RyanPage-cu/SYSC4805_Project_Repo/(commit log)

2025-10-11 adding another line sensor code
2025-10-11 Refactor setup and loop functions to include all line follower sensor pins and update logic for reading sensor states
2025-10-12 Update motor and sensor pin definitions for improved functionality
2025-10-12 Add Due_Code.cpp with motor control, ultrasonic sensor, and line follower functionality
2025-10-31 Add distance sensor functionality with reporting
    Implement distance sensing using two Sharp GP2Y0A51SK0F sensors. Each sensor reports if an object is detected within ~8 cm based on voltage readings.
2025-11-14 Add Watchdog timer
2025-11-16 Refactor distance sensor and ultrasonic modules for improved readability and functionality
2025-11-16 Rename ultrasonic function for clarity and add readSharpDistances function for improved distance measurement
2025-11-19 Refactor ultrasonic distance reading functions for improved accuracy and add stepForward function for controlled movement
2025-11-19 Add test main function for standalone testing of sensors and motors
2025-11-19 Refactor loop function to improve readability and temporarily disable sensor detection logic
2025-11-20 Add Time of Flight sensor implementation and refactor pivot control for non-blocking operation
2025-11-20 Implement dual Time of Flight sensor initialization and reading; refactor sensor setup in main file
2025-11-20 Refactor distance sensor implementation: remove Sharp sensor code, update ultrasonic sensor functions for dual sensor support, and adjust main loop for new readings.
2025-11-20 Enhance Time of Flight sensor initialization with error handling and success messages; refactor distance reading logic in main loop for clarity and improved functionality.
    [roboplow.ino]
2025-11-20 Refactor sensor modules: remove ultrasonic and line follower implementations, add IR obstacle detection sensor functionality, and update sensor initialization in main file.
2025-11-21 Refactor sensor initialization: add functions for motor, ultrasonic, line detection, and IR sensor setup; remove line detection sensor implementation file.
2025-11-21 Add magnetometer direction support
2025-11-26 Prototype implementation of FSM
2025-11-26 sensors.hpp -> sensor_manager.hpp
2025-11-27 Fix char/string related issues with magnetometer
    [roboplow.ino, sensor_manager.hpp]
2025-11-27 Add stopAll() call to pivotTurn for improved motor control
2025-11-27 Refactor obstacle avoidance logic for improved maneuvering and control dpeending on starting location
    [roboplow.ino]
2025-11-27 Enhance obstacle avoidance logic with additional maneuvers based on initial heading and starting side
    [roboplow.ino]
2025-11-28 safe version, to be iterated on once batteries are charged
2025-11-29 add previously missing unit tests
    [ir_obstacle_test.ino, magnetometer_test.ino, tof_test.ino]
